cehbz/aqm-sensor/3d Models/530480810.stp

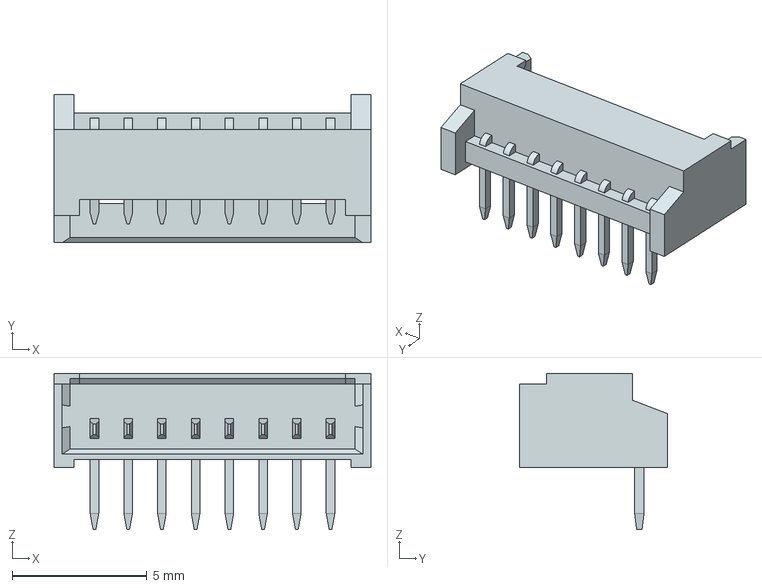
[picture p1: CAD file, 2026-03-20]
3d Models/530480810.stp
11.8 x 5.50 x 5.80 mm
