cehbz/aqm-sensor/aqm_sensor.kicad_pcb

## KiCad design aqm_sensor.kicad_pcb (2026-03-21)

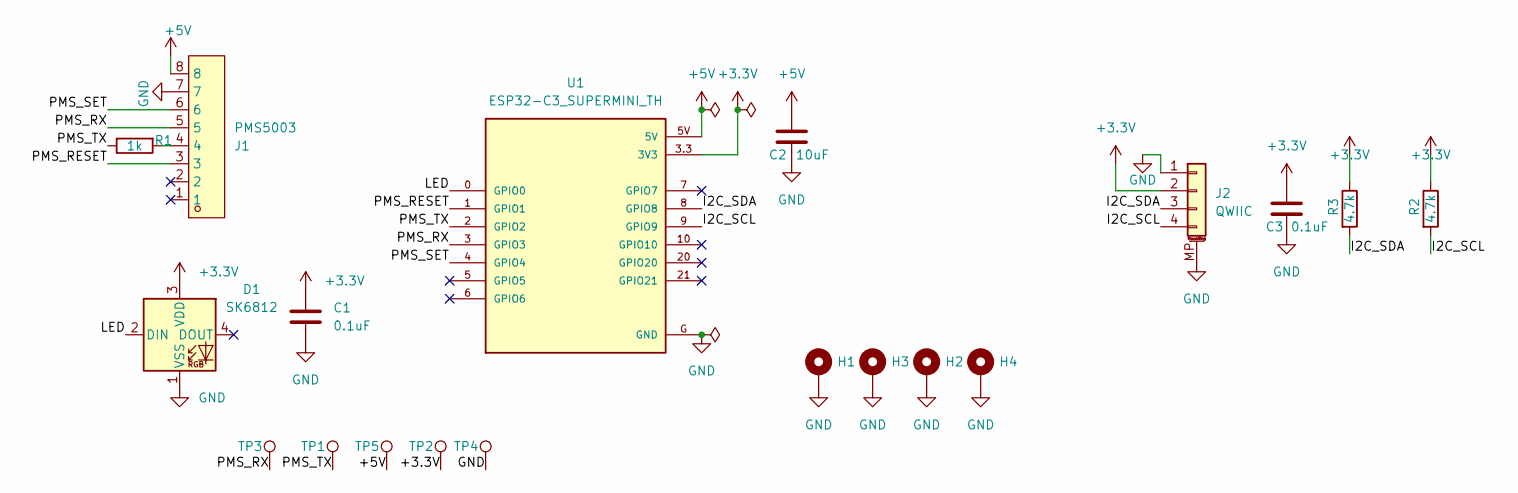
[picture p2: schematic aqm_sensor.kicad_sch]

Parts:
C1, C3: 0.1uF; C_1206_3216Metric
C2: 10uF; C_0805_2012Metric
D1: SK6812; LED_SK6812_PLCC4_5.0x5.0mm_P3.2mm
H1, H2, H3, H4: MountingHole_2.7mm_M2.5_Pad_Via
J1: PMS5003; CONN-TH_8P-P1.25_HCTL_HC-1.25-8AW; LCSC Part C2845541
J2: QWIIC; JST_SH_SM04B-SRSS-TB_1x04-1MP_P1.00mm_Horizontal
R1: 1k; R_1206_3216Metric
R2, R3: 4.7k; R_1206_3216Metric
TP1: TX; TestPoint_Loop_D2.50mm_Drill1.0mm
TP2: 3.3V; TestPoint_Pad_D1.5mm
TP3: RX; TestPoint_Loop_D2.50mm_Drill1.0mm
TP4: GND; TestPoint_Pad_D1.5mm
TP5: 5V; TestPoint_Pad_D1.5mm
U1: ESP32-C3_SUPERMINI_TH; MODULE_ESP32-C3_SUPERMINI_TH

Connections:
+3.3V: C1.2, C3.2, D1.3 (VDD), J2.2, R2.1, R3.1, TP2.1, U1.3.3 (3V3)
+5V: C2.1, J1.8, TP5.1, U1.5V
/I2C_SCL: J2.4, R2.2, U1.9 (GPIO9)
/I2C_SDA: J2.3, R3.2, U1.8 (GPIO8)
/LED: D1.2 (DIN), U1.0 (GPIO0)
/PMS_RESET: J1.3, U1.1 (GPIO1)
/PMS_RX: J1.5, TP3.1, U1.3 (GPIO3)
/PMS_SET: J1.6, U1.4 (GPIO4)
/PMS_TX: R1.1, TP1.1, U1.2 (GPIO2)
GND: C1.1, C2.2, C3.1, D1.1 (VSS), H1.1, H2.1, H3.1, H4.1, J1.7, J2.1, J2.MP (MountPin), TP4.1, U1.G (GND)
unnamed: J1.4, R1.2

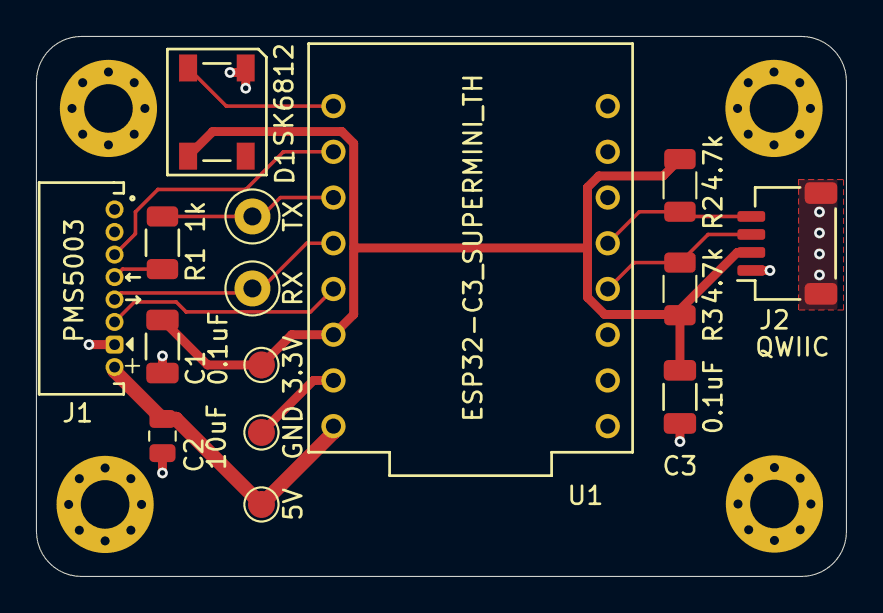
[picture p3: board aqm_sensor.kicad_pcb from above]

Board: 2 copper layers, 45.0 x 30.0 mm, 19 parts (0 on the bottom side), 11 nets.
