cehbz/aqm-sensor/(commit log)

2026-03-20 Initial commit: v1 board as sent to JLCPCB for fabrication
    ESP32-C3 SuperMini air quality monitor with PMS5003 sensor,
    SK6812 RGB LED, and QWIIC I2C expansion. Includes KiCad 9
    schematic/PCB, gerbers, and ESP-IDF firmware.
    Known issues documented in TODO.md and CLAUDE.md.
    [530480810.stp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]
2026-03-21 v2 schematic and PCB rework
    Schematic:
    - Rewire J3 for PMS5003 cable mirror (pin 1↔8 reversal)
    - Add I2C pull-up resistors R1, R2 (4.7k) on SDA/SCL
    - Replace C4 100uF electrolytic with 10uF 0805 ceramic
    - Fix J3 pin types from Unspecified to Passive (ERC clean)
    - Add test points: TP1/TP2 (loop) for RX/TX, TP3-TP5 (pad) for power
    - Fix C1 value capitalization (0.1uf → 0.1uF)
    PCB:
    - Rotate U3 180° to correct antenna orientation
    - Place new components (R1, R2, C4, TP1-TP5)
    - Reroute for updated netlist
    - Add GND stitching vias
    Removes TODO.md (tracked in CLAUDE.md known issues).
    [aqm_sensor.kicad_pcb, aqm_sensor.kicad_sch]
2026-03-21 Update CLAUDE.md for v2 component renumbering and pin mapping
    U3→U1, J3→J1, R5→R1. Pin mapping reflects corrected footprint
    orientation and cable-mirrored J1 wiring.
2026-03-24 v0.2: Gerbers as sent to JLCPCB
    [aqm_sensor-B_Cu.gbl, aqm_sensor-B_Mask.gbs, aqm_sensor-B_Paste.gbp, aqm_sensor-B_Silkscreen.gbo, aqm_sensor-Edge_Cuts.gm1, aqm_sensor-F_Cu.gtl, aqm_sensor-F_Mask.gts, aqm_sensor-F_Paste.gtp]
2026-04-02 Smoke test firmware: WiFi + NTP + MQTT + PMS5003 + HA Discovery
    Replaced diagnostic main.c with C++ firmware. Adds WiFi (auto-reconnect,
    reduced TX power), NTP, MQTT with LWT, PMS5003 sensor integration, and
    HA Discovery for 9 PM/particle entities + RSSI diagnostic. SK6812 LED
    reflects PM2.5 levels. Updated CLAUDE.md with architecture analysis and
    domain model. Added TODO for ESP-WIFI-MESH migration.
    [aqm_sensor.kicad_sch]
